mmornati/weather-station-zigbee/(commit log)

2026-10-28 Weather Station Zigbee v1: firmware, converter, HA package, 3D parts
    Solar Zigbee weather station on the Seeed XIAO ESP32-C6, following the
    water-flow-meter-zigbee and reed-contact-zigbee projects.
    - Firmware: sleepy end device. Deep sleep between wakes; rain tips wake it
    (ext1 on D1), a 3 s anemometer window in light sleep every minute, a Zigbee
    report every 5 minutes (every minute while it rains). Optional LTR390,
    AS3935 and two DS18B20 probes detected at power-on.
    - weather_logic.h: vane decoding, wind average/gust/vector direction, rain
    bounce guard, tick clock across deep sleep, battery curve, light
    conversions, with host unit tests.
    - Zigbee2MQTT external converter that only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
    [common.scad, electronics_box.scad, panel_bracket.scad, pole_saddle.scad, radiation_shield.scad, rain_gauge_plate.scad]
2026-10-29 Website, build guide, renders and FR/IT docs
    - site/: EN/FR/IT website in the style of the other ESP32 projects, with a
    live-readings demo, renders of the station, a nine-step build guide that
    links to every file, a printed-parts gallery with STL downloads, the
    browser flasher, the HA package, BOM and FAQ
    - Pages workflow: builds the firmware for the flasher and the STL files
    (one by one and as a zip) and publishes site/
    - CI: website translations test, site links checked
    - hardware/3d: angle_bracket.scad, so the shield arm and the rain gauge
    plate (horizontal M4 square) can bolt to a saddle on a vertical pole;
    station_render.scad + render_images.sh make the pictures in site/img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
    [angle_bracket.scad, station_render.scad]
2026-10-29 Firmware: use OneWire master, 2.3.8 doesn't build on the ESP32-C6
    The PlatformIO and Arduino CLI builds failed on main in OneWire_direct_gpio.h
    (GPIO.out_w1ts assignments); OneWire master has the ESP32-C6 fix.
    Claude-Session: https://claude.ai/code/session_01TAigdD55HzvPxspJxrSLn3
